LetsBuildRockets/ToF-CAN/hardware/id numbers.xls

CAN ID: 0x0620
CAN ID: 0x0621
CAN ID: 0x0622
CAN ID: 0x0623
CAN ID: 0x0624
CAN ID: 0x0625
CAN ID: 0x0626
CAN ID: 0x0627
CAN ID: 0x0628
CAN ID: 0x0629
CAN ID: 0x062A
CAN ID: 0x062B
CAN ID: 0x062C
CAN ID: 0x062D
CAN ID: 0x062E
CAN ID: 0x062F
CAN ID: 0x0630
CAN ID: 0x0631
CAN ID: 0x0632
CAN ID: 0x0633
CAN ID: 0x0634
CAN ID: 0x0635
CAN ID: 0x0636
CAN ID: 0x0637
CAN ID: 0x0638
CAN ID: 0x0639
CAN ID: 0x063A
CAN ID: 0x063B
CAN ID: 0x063C
CAN ID: 0x063D
CAN ID: 0x063E
CAN ID: 0x063F
CAN ID: 0x0640
CAN ID: 0x0641
CAN ID: 0x0642
CAN ID: 0x0643
CAN ID: 0x0644
CAN ID: 0x0645
CAN ID: 0x0646
CAN ID: 0x0647
CAN ID: 0x0648
CAN ID: 0x0649
CAN ID: 0x064A
CAN ID: 0x064B
CAN ID: 0x064C
CAN ID: 0x064D
CAN ID: 0x064E
CAN ID: 0x064F
CAN ID: 0x0650
CAN ID: 0x0651
CAN ID: 0x0652
CAN ID: 0x0653
CAN ID: 0x0654
CAN ID: 0x0655
CAN ID: 0x0656
CAN ID: 0x0657
CAN ID: 0x0658
CAN ID: 0x0659
CAN ID: 0x065A
CAN ID: 0x065B
CAN ID: 0x065C
CAN ID: 0x065D
CAN ID: 0x065E
CAN ID: 0x065F
CAN ID: 0x0660
CAN ID: 0x0661
CAN ID: 0x0662
CAN ID: 0x0663
CAN ID: 0x0664
CAN ID: 0x0665
CAN ID: 0x0666
CAN ID: 0x0667
CAN ID: 0x0668
CAN ID: 0x0669
CAN ID: 0x066A
CAN ID: 0x066B
CAN ID: 0x066C
CAN ID: 0x066D
CAN ID: 0x066E
CAN ID: 0x066F
CAN ID: 0x0670
CAN ID: 0x0671
CAN ID: 0x0672
CAN ID: 0x0673
CAN ID: 0x0674
CAN ID: 0x0675
CAN ID: 0x0676
CAN ID: 0x0677
CAN ID: 0x0678
CAN ID: 0x0679
CAN ID: 0x067A
CAN ID: 0x067B
CAN ID: 0x067C
CAN ID: 0x067D
CAN ID: 0x067E
CAN ID: 0x067F
CAN ID: 0x0680
CAN ID: 0x0681
CAN ID: 0x0682
CAN ID: 0x0683
CAN ID: 0x0684
CAN ID: 0x0685
CAN ID: 0x0686
CAN ID: 0x0687
CAN ID: 0x0688
CAN ID: 0x0689
CAN ID: 0x068A
CAN ID: 0x068B
CAN ID: 0x068C
CAN ID: 0x068D
CAN ID: 0x068E
CAN ID: 0x068F
CAN ID: 0x0690
CAN ID: 0x0691
CAN ID: 0x0692
CAN ID: 0x0693
CAN ID: 0x0694
CAN ID: 0x0695
CAN ID: 0x0696
CAN ID: 0x0697
CAN ID: 0x0698
CAN ID: 0x0699
CAN ID: 0x069A
CAN ID: 0x069B
CAN ID: 0x069C
CAN ID: 0x069D
CAN ID: 0x069E
CAN ID: 0x069F
CAN ID: 0x06A0
CAN ID: 0x06A1
CAN ID: 0x06A2
CAN ID: 0x06A3
CAN ID: 0x06A4
CAN ID: 0x06A5
CAN ID: 0x06A6
CAN ID: 0x06A7
CAN ID: 0x06A8
CAN ID: 0x06A9
CAN ID: 0x06AA
CAN ID: 0x06AB
CAN ID: 0x06AC
CAN ID: 0x06AD
CAN ID: 0x06AE
CAN ID: 0x06AF
CAN ID: 0x06B0
CAN ID: 0x06B1
CAN ID: 0x06B2
CAN ID: 0x06B3
CAN ID: 0x06B4
CAN ID: 0x06B5
CAN ID: 0x06B6
CAN ID: 0x06B7
CAN ID: 0x06B8
CAN ID: 0x06B9
CAN ID: 0x06BA
CAN ID: 0x06BB
CAN ID: 0x06BC
CAN ID: 0x06BD
CAN ID: 0x06BE
CAN ID: 0x06BF
CAN ID: 0x06C0
CAN ID: 0x06C1
CAN ID: 0x06C2
CAN ID: 0x06C3
CAN ID: 0x06C4
CAN ID: 0x06C5
CAN ID: 0x06C6
CAN ID: 0x06C7
CAN ID: 0x06C8
CAN ID: 0x06C9
CAN ID: 0x06CA
CAN ID: 0x06CB
CAN ID: 0x06CC
CAN ID: 0x06CD
CAN ID: 0x06CE
CAN ID: 0x06CF
CAN ID: 0x06D0
CAN ID: 0x06D1
CAN ID: 0x06D2
CAN ID: 0x06D3
CAN ID: 0x06D4
CAN ID: 0x06D5
CAN ID: 0x06D6
CAN ID: 0x06D7
CAN ID: 0x06D8
CAN ID: 0x06D9
CAN ID: 0x06DA
CAN ID: 0x06DB
CAN ID: 0x06DC
CAN ID: 0x06DD
CAN ID: 0x06DE
CAN ID: 0x06DF
CAN ID: 0x06E0
CAN ID: 0x06E1
CAN ID: 0x06E2
CAN ID: 0x06E3
CAN ID: 0x06E4
CAN ID: 0x06E5
CAN ID: 0x06E6
CAN ID: 0x06E7
CAN ID: 0x06E8
CAN ID: 0x06E9
CAN ID: 0x06EA
CAN ID: 0x06EB
CAN ID: 0x06EC
CAN ID: 0x06ED
CAN ID: 0x06EE
CAN ID: 0x06EF
CAN ID: 0x06F0
CAN ID: 0x06F1
CAN ID: 0x06F2
CAN ID: 0x06F3
CAN ID: 0x06F4
CAN ID: 0x06F5
CAN ID: 0x06F6
CAN ID: 0x06F7
CAN ID: 0x06F8
CAN ID: 0x06F9
CAN ID: 0x06FA
CAN ID: 0x06FB
CAN ID: 0x06FC
CAN ID: 0x06FD
CAN ID: 0x06FE
CAN ID: 0x06FF
