LetsBuildRockets/ToF-CAN/hardware/CAD/TOF Case P1.stl

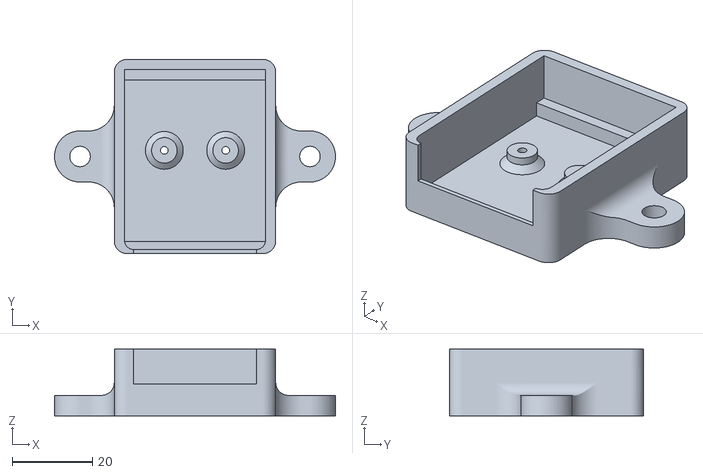
[picture p1: CAD file, 2019-03-20]
hardware/CAD/TOF Case P1.stl
69.8 x 48.3 x 16.6
