LetsBuildRockets/ToF-CAN/hardware/CAD/TOF Case P2_ISO.stl

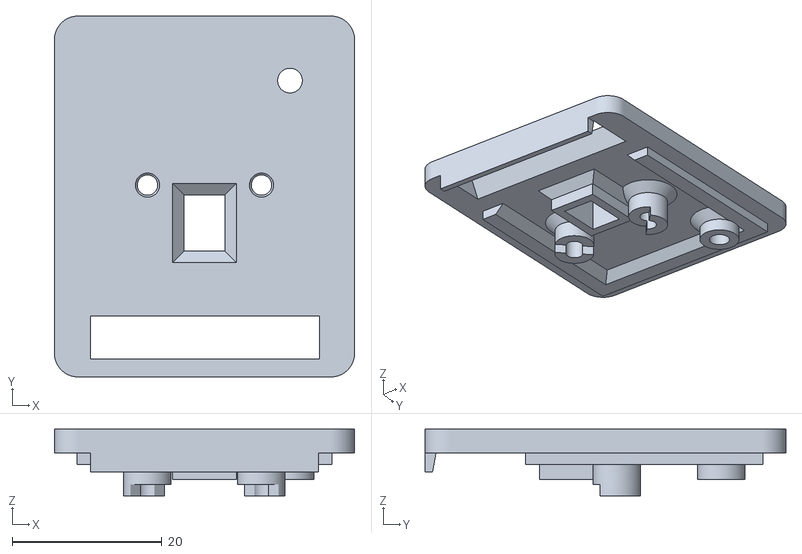
[picture p2: CAD file, 2019-03-20]
hardware/CAD/TOF Case P2_ISO.stl
40.1 x 48.3 x 8.92
