LetsBuildRockets/ToF-CAN/(list of files, cad)

Other CAD files:
hardware/CAD/TOF Assembly.dwg
hardware/CAD/CAN TOF/1X07.ipt
hardware/CAD/CAN TOF/B1,27.ipt
hardware/CAD/CAN TOF/Board.ipt
hardware/CAD/CAN TOF/C0402.ipt
hardware/CAD/CAN TOF/C0805.ipt
hardware/CAD/CAN TOF/CAN TOF.iam
hardware/CAD/CAN TOF/CTS406.ipt
hardware/CAD/CAN TOF/FUSC3216X100N.ipt
hardware/CAD/CAN TOF/ISP.ipt
hardware/CAD/CAN TOF/PCB Component.iam
hardware/CAD/CAN TOF/Pin.ipt
hardware/CAD/CAN TOF/R0805.ipt
hardware/CAD/CAN TOF/RGBLED5050.ipt
hardware/CAD/CAN TOF/SCREWTERMINAL-5MM-2.iam
hardware/CAD/CAN TOF/SMA-DO214AC.ipt
hardware/CAD/CAN TOF/SO08.ipt
hardware/CAD/CAN TOF/SO18W.ipt
hardware/CAD/CAN TOF/SOT-23.ipt
hardware/CAD/CAN TOF/SOT23-3.ipt
hardware/CAD/CAN TOF/ScrewTerminalCover.ipt
hardware/CAD/CAN TOF/TQFP32-08.ipt
hardware/CAD/CAN TOF/pan head cross recess screw_iso_ISO 7045 - M2 x 3 - Z - 3N.ipt
hardware/CAD/CAN TOF/part.ipt
hardware/CAD/TOF Assembly.iam
hardware/CAD/TOF Case P1.ipt
hardware/CAD/TOF Case P2.ipt
hardware/CAD/TOF Case P2_ISO.ipt
