LetsBuildRockets/ToF-CAN/hardware/CAN TOF.pdf

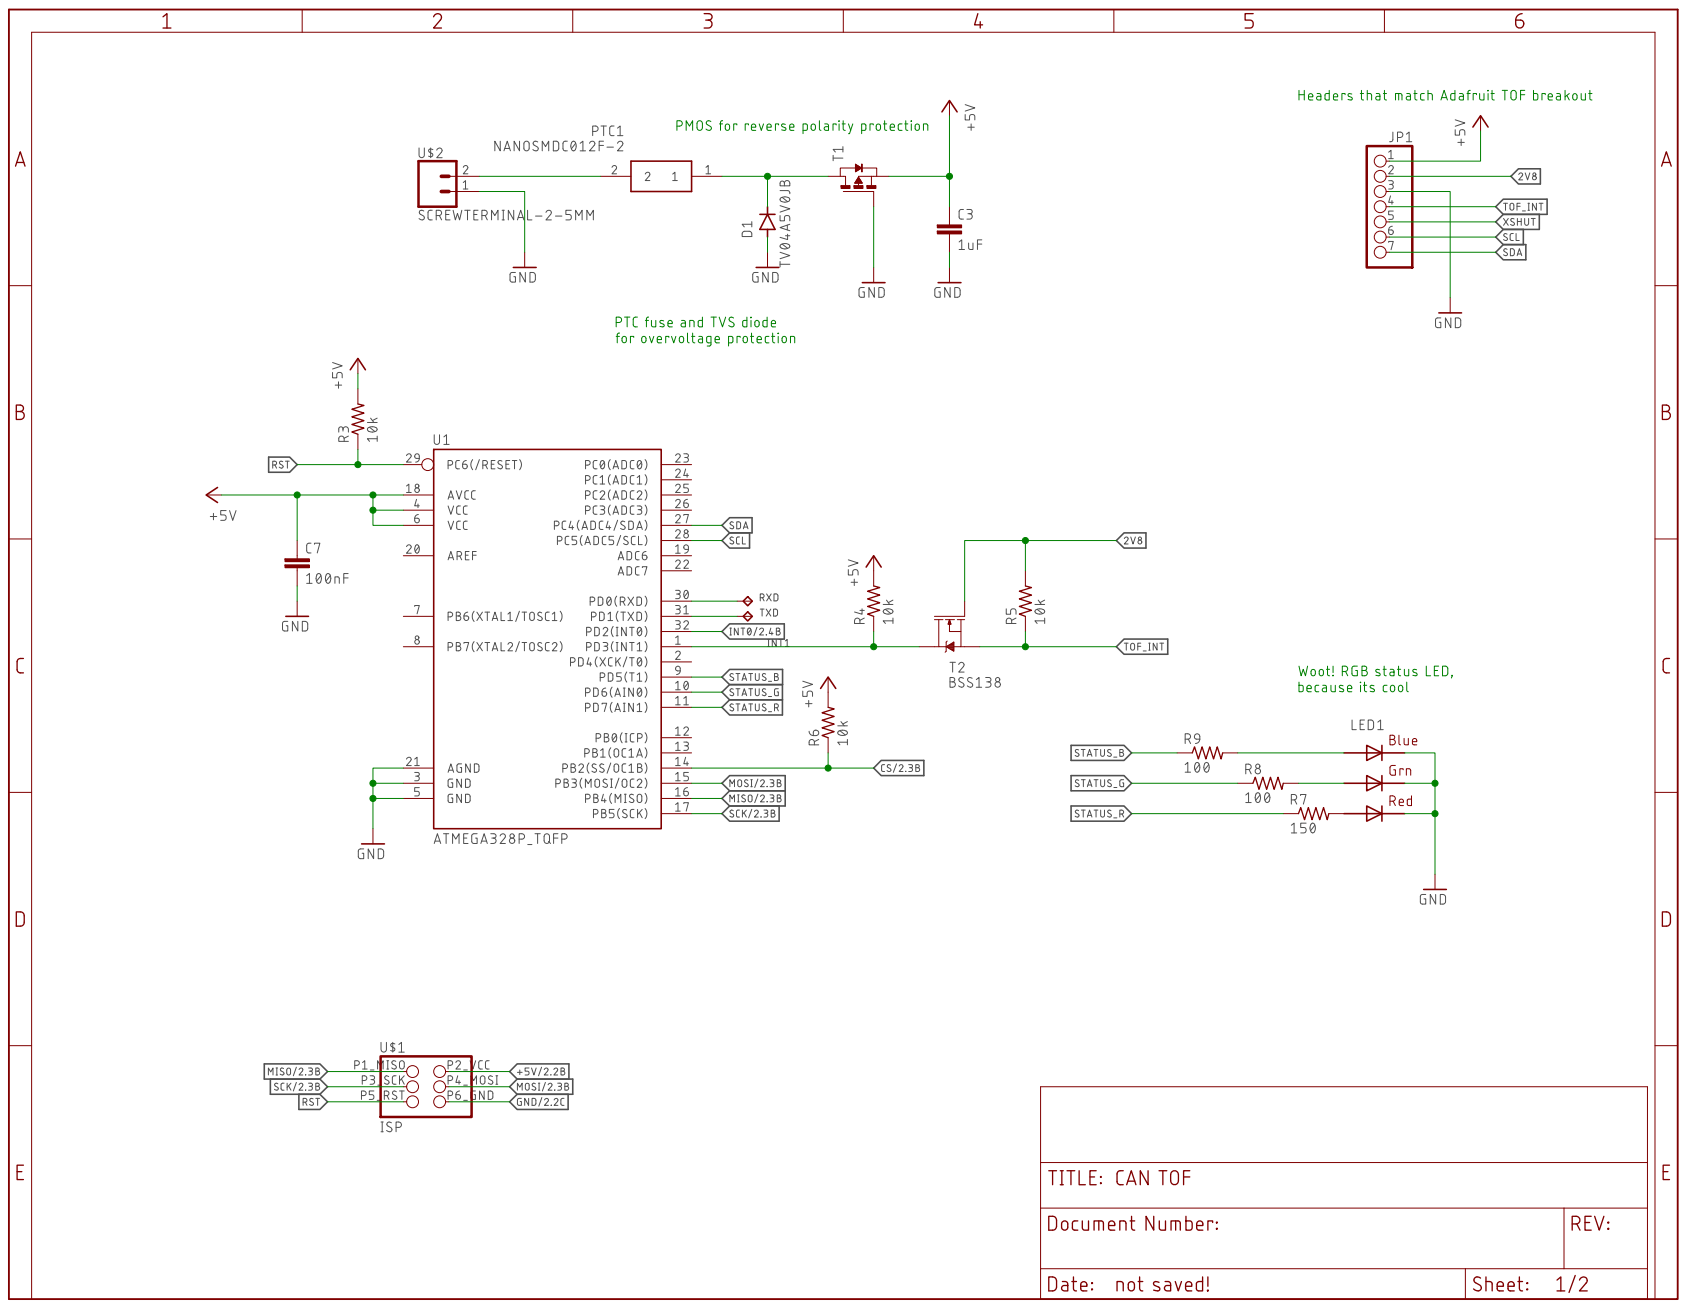
[picture p3: page 1]

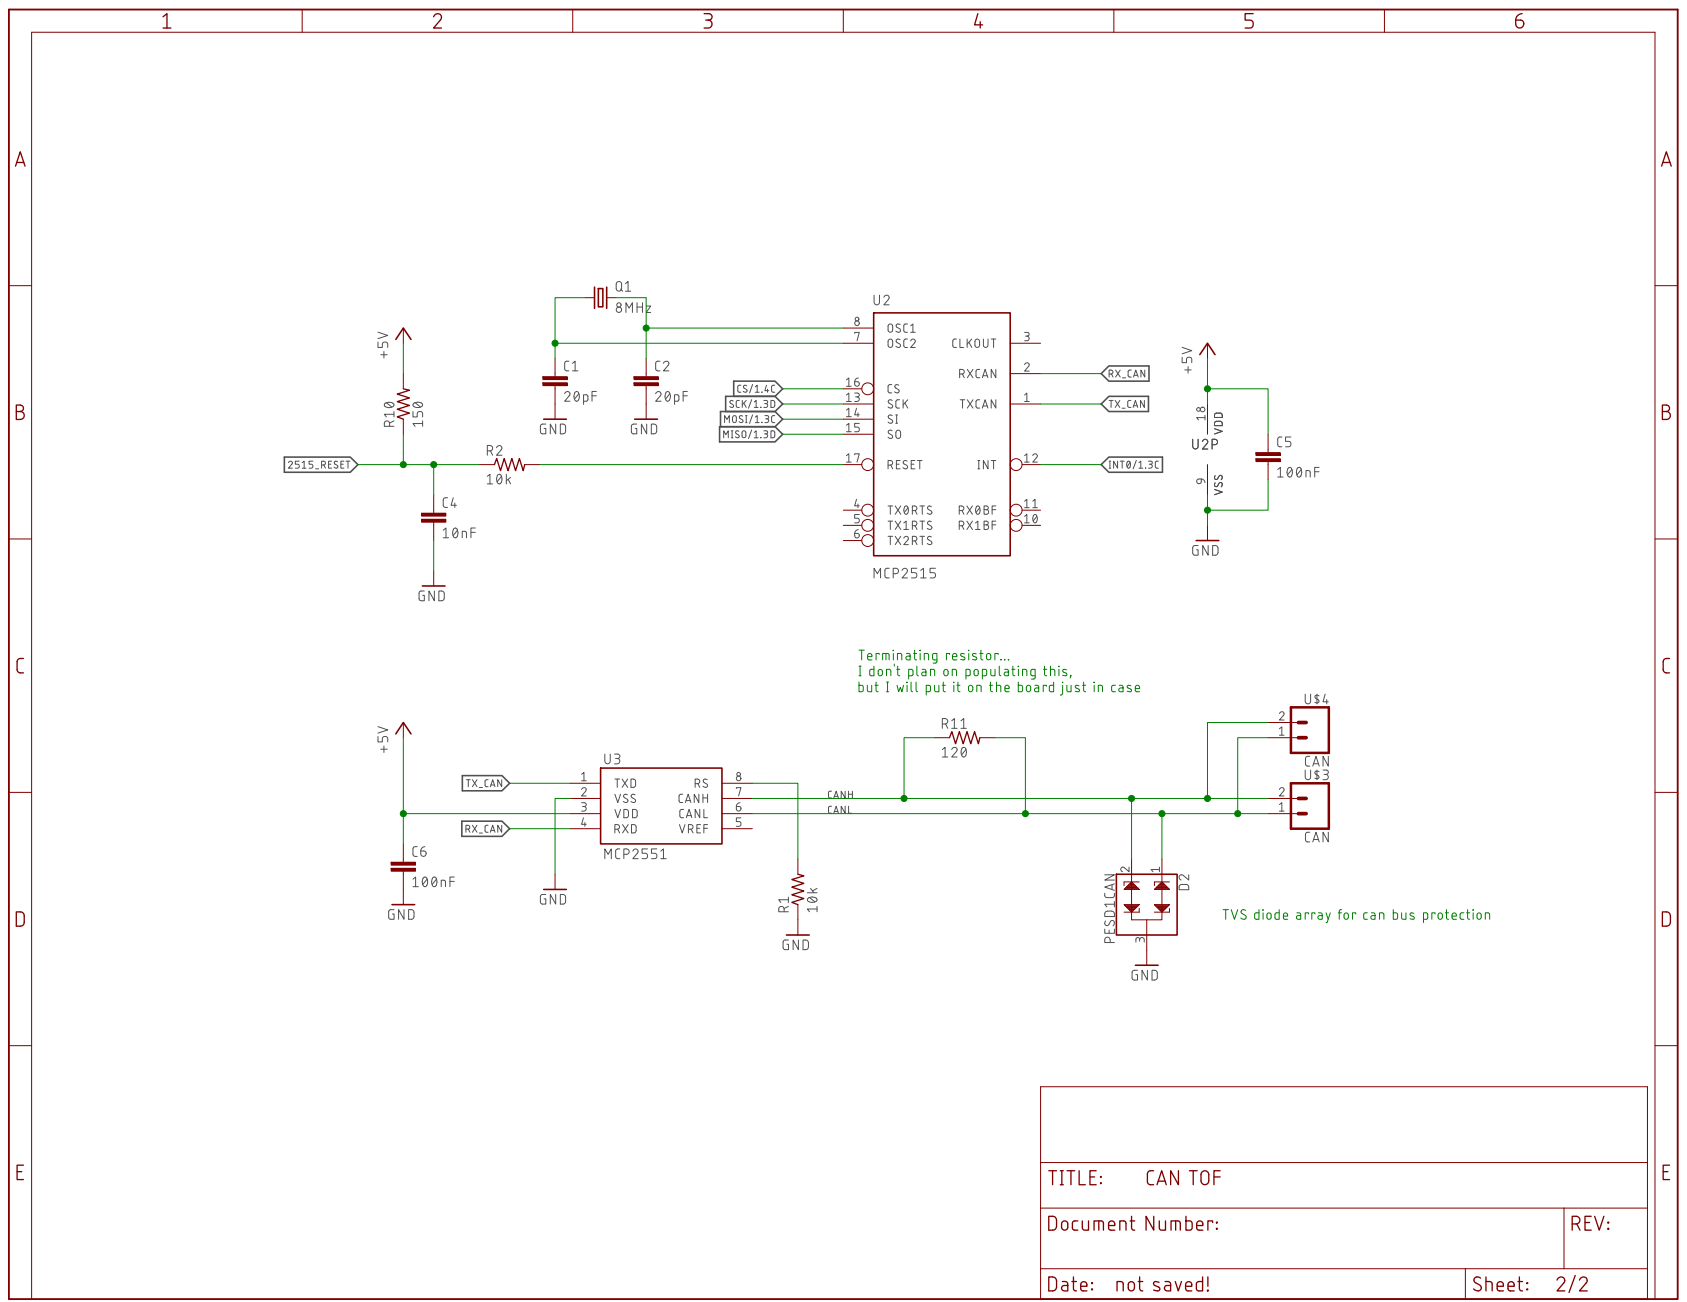
[picture p4: page 2]
