LetsBuildRockets/ToF-CAN/hardware/CAD/TOF Assembly.pdf

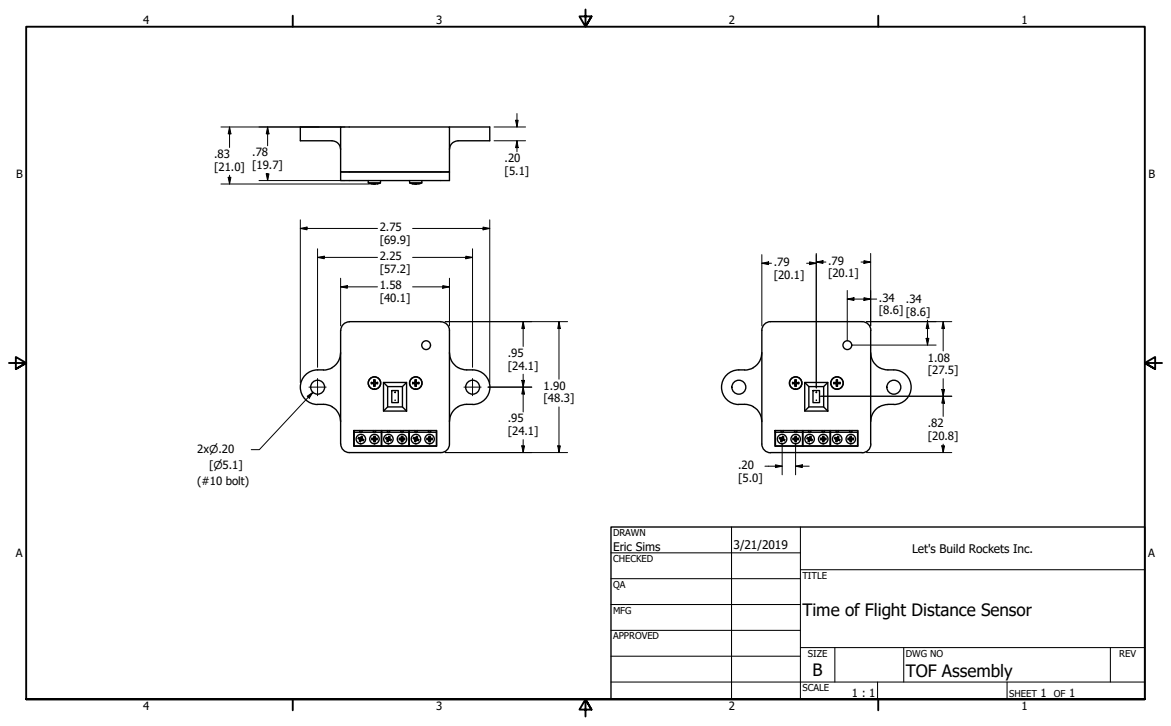
[picture p5: page 1]

D RA W N E r i c S i m s | 3 / 2 1 / 2 0 1 9 | L e t ' s B u ild R o c ke t s I n c .

S I Z E B | D W G N O T O F A s s e m bly | R E V
