LetsBuildRockets/ToF-CAN/hardware/CAN TOF.brd

## EAGLE design hardware/CAN TOF.brd (2019-03-20)

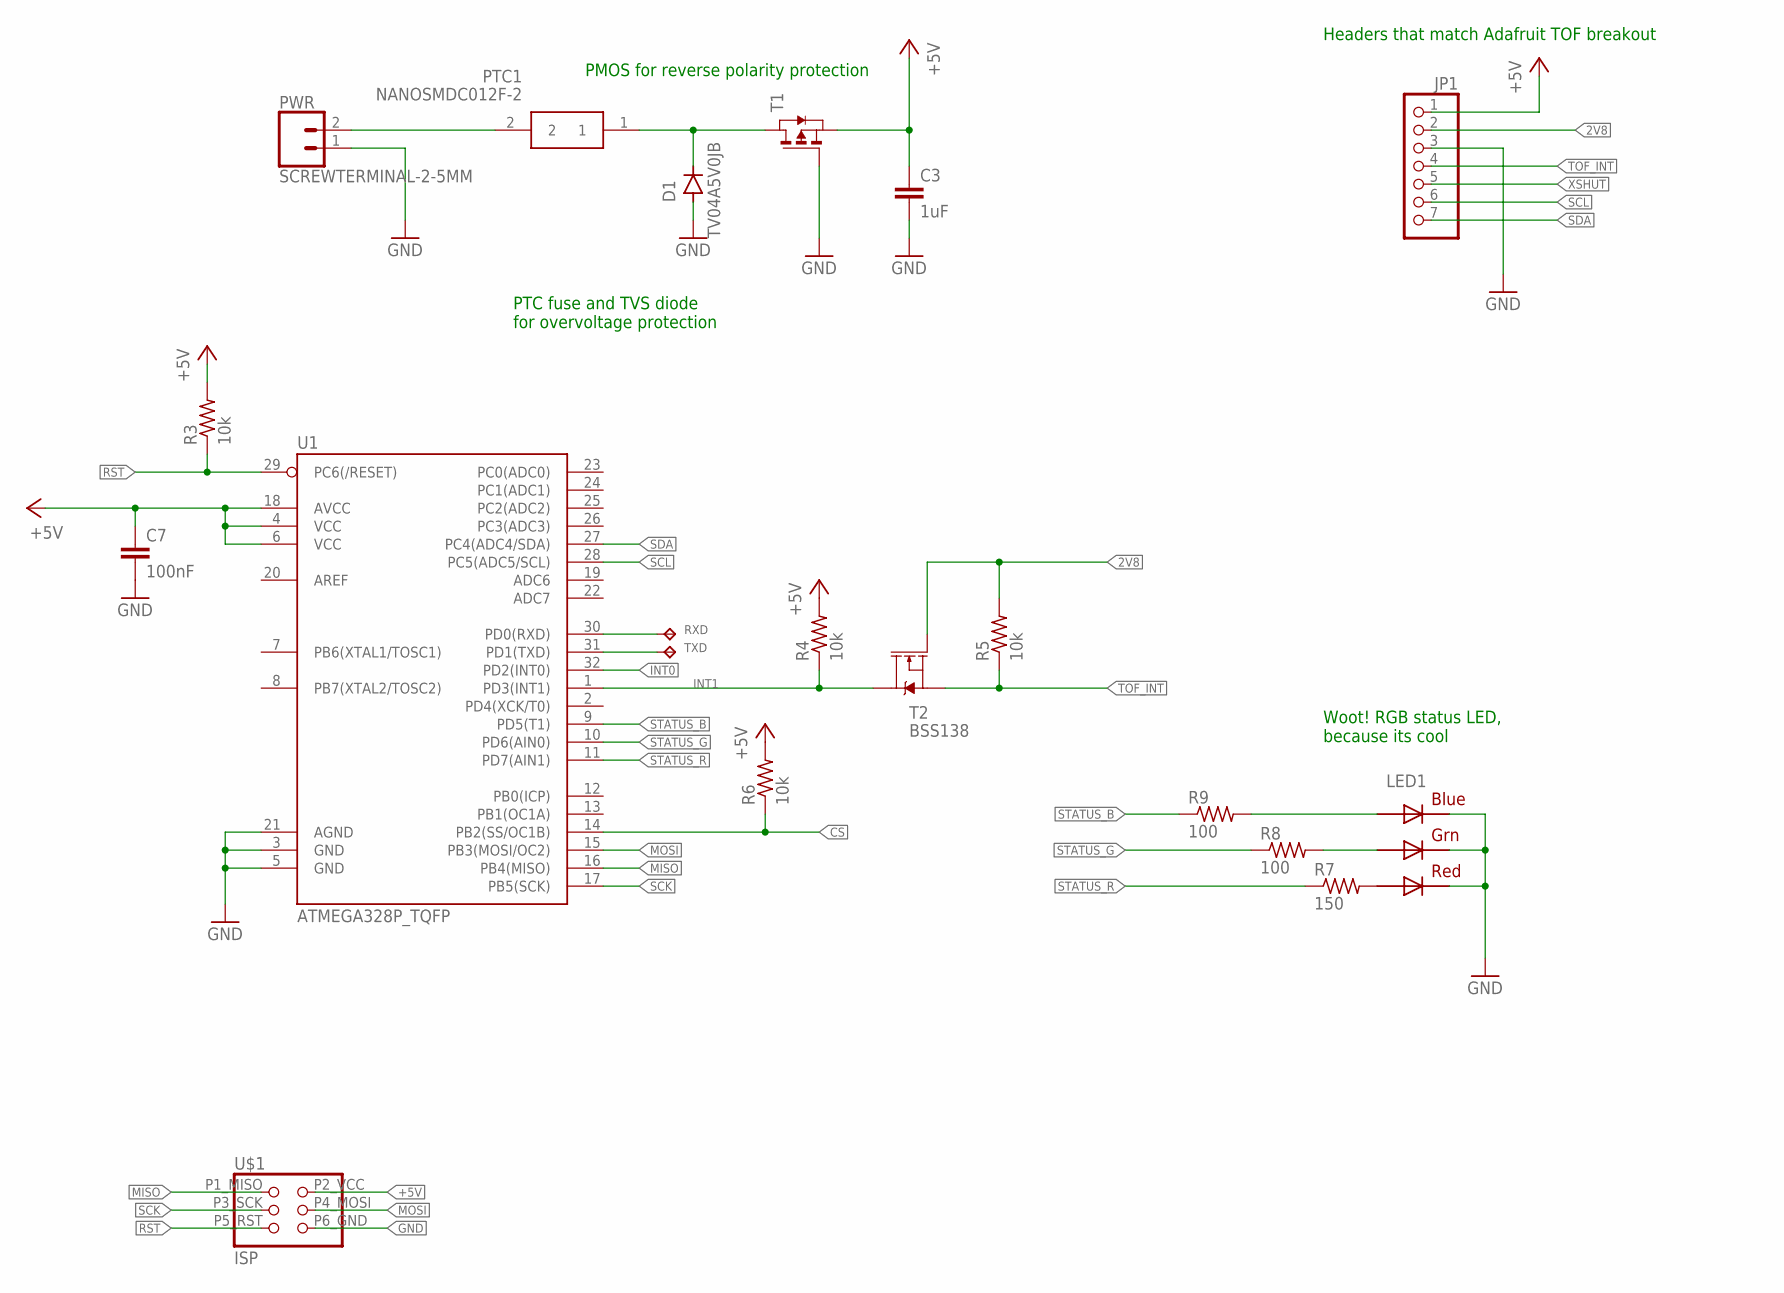
[picture p6: schematic CAN TOF.sch, sheet 1]

Parts:
C3: 1uF; C0805
C7: 100nF; C0402
D1: TV04A5V0JB; SMA-DO214AC
JP1: PINHD-1X7; 1X07
LED1: RGBLED5050
PTC1: NANOSMDC012F-2; FUSC3216X100N
PWR: SCREWTERMINAL-2-5MM; SCREWTERMINAL-5MM-2
R3, R4, R5, R6: 10k; R0805
R7: 150; R0805
R8, R9: 100; R0805
RXD: TPB1,27; B1,27
T1: PMOSSOT23; SOT-23
T2: BSS138; SOT23-3
TXD: TPB1,27; B1,27
U1: ATMEGA328P_TQFP; TQFP32-08
U$1: ISP

Connections:
2V8: JP1.2, R5.2, T2.1 (G)
+5V: C3.1, C7.1, JP1.1, R3.2, R4.2, R6.2, T1.2 (S), U1.4 (VCC), U1.6 (VCC), U1.18 (AVCC), U$1.P2_VCC (VCC); also elsewhere on the board
CS: R6.1, U1.14 (PB2(SS/OC1B)); also elsewhere on the board
GND: C3.2, C7.2, D1.A, JP1.3, LED1.4 (BLUE_C), LED1.5 (RED_C), LED1.6 (GREEN_C), PWR.1, T1.3 (G), U1.3 (GND), U1.5 (GND), U1.21 (AGND), U$1.P6_GND (GND); also elsewhere on the board
INT0: U1.32 (PD2(INT0)); also elsewhere on the board
INT1: R4.1, T2.3 (D), U1.1 (PD3(INT1))
MISO: U1.16 (PB4(MISO)), U$1.P1_MISO (MISO); also elsewhere on the board
MOSI: U1.15 (PB3(MOSI/OC2)), U$1.P4_MOSI (MOSI); also elsewhere on the board
unnamed: RXD.TP, U1.30 (PD0(RXD))
unnamed: TXD.TP, U1.31 (PD1(TXD))
unnamed: PTC1.2, PWR.2
unnamed: D1.K (C), PTC1.1, T1.1 (D)
unnamed: LED1.2 (RED_A), R7.2
unnamed: LED1.1 (GREEN_A), R8.2
unnamed: LED1.3 (BLUE_A), R9.2
RST: R3.1, U1.29 (PC6(/RESET)), U$1.P5_RST (RST)
SCK: U1.17 (PB5(SCK)), U$1.P3_SCK (SCK); also elsewhere on the board
SCL: JP1.6, U1.28 (PC5(ADC5/SCL))
SDA: JP1.7, U1.27 (PC4(ADC4/SDA))
STATUS_B: R9.1, U1.9 (PD5(T1))
STATUS_G: R8.1, U1.10 (PD6(AIN0))
STATUS_R: R7.1, U1.11 (PD7(AIN1))
TOF_INT: JP1.4, R5.1, T2.2 (S)
XSHUT: JP1.5

Notes on the sheet:
PTC fuse and TVS diode for overvoltage protection
PMOS for reverse polarity protection
Headers that match Adafruit TOF breakout
Woot! RGB status LED, because its cool

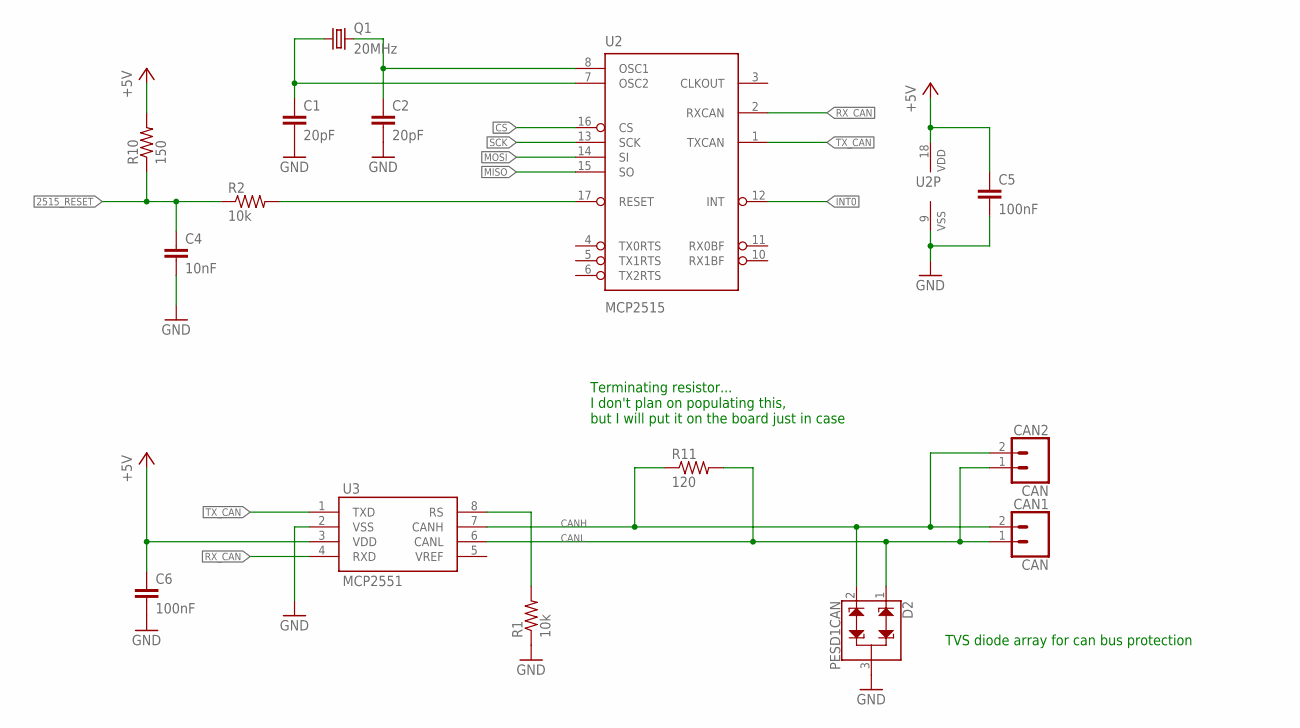
[picture p7: schematic CAN TOF.sch, sheet 2]

Parts:
C1, C2: 20pF; C0402
C4: 10nF; C0402
C5, C6: 100nF; C0402
CAN1, CAN2: CAN; SCREWTERMINAL-5MM-2
D2: PESD1CAN; SOT23-3
Q1: 20MHz; CTS406
R1, R2: 10k; R0805
R10: 150; R0805
R11: 120; R0805
U2: MCP2515; SO18W
U3: MCP2551; SO08

Connections:
2515_RESET: C4.1, R2.1, R10.1
+5V: C5.1, C6.1, R10.2, U2.18 (VDD), U3.3 (VDD); also elsewhere on the board
CANH: CAN1.2, CAN2.2, D2.2, R11.1, U3.7 (CANH)
CANL: CAN1.1, CAN2.1, D2.1, R11.2, U3.6 (CANL)
CS: U2.16 (CS); also elsewhere on the board
GND: C1.2, C2.2, C4.2, C5.2, C6.2, D2.3, R1.1, U2.9 (VSS), U3.2 (VSS); also elsewhere on the board
INT0: U2.12 (INT); also elsewhere on the board
MISO: U2.15 (SO); also elsewhere on the board
MOSI: U2.14 (SI); also elsewhere on the board
unnamed: R1.2, U3.8 (RS)
unnamed: R2.2, U2.17 (RESET)
unnamed: C1.1, Q1.1, U2.7 (OSC2)
unnamed: C2.1, Q1.3 (2), U2.8 (OSC1)
RX_CAN: U2.2 (RXCAN), U3.4 (RXD)
SCK: U2.13 (SCK); also elsewhere on the board
TX_CAN: U2.1 (TXCAN), U3.1 (TXD)

Notes on the sheet:
TVS diode array for can bus protection
Terminating resistor... I don't plan on populating this, but I will put it on the board just in case

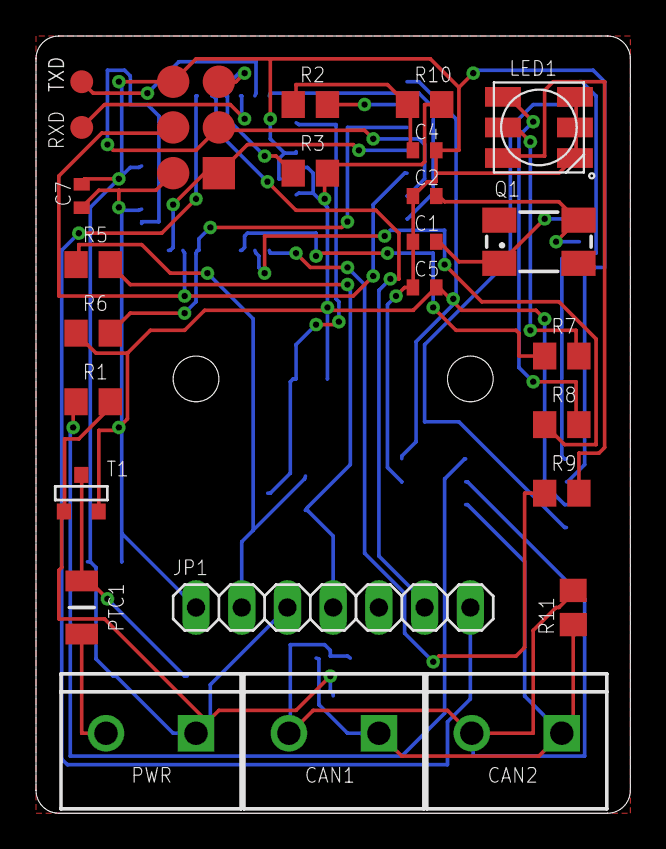
[picture p8: board CAN TOF.brd from above]

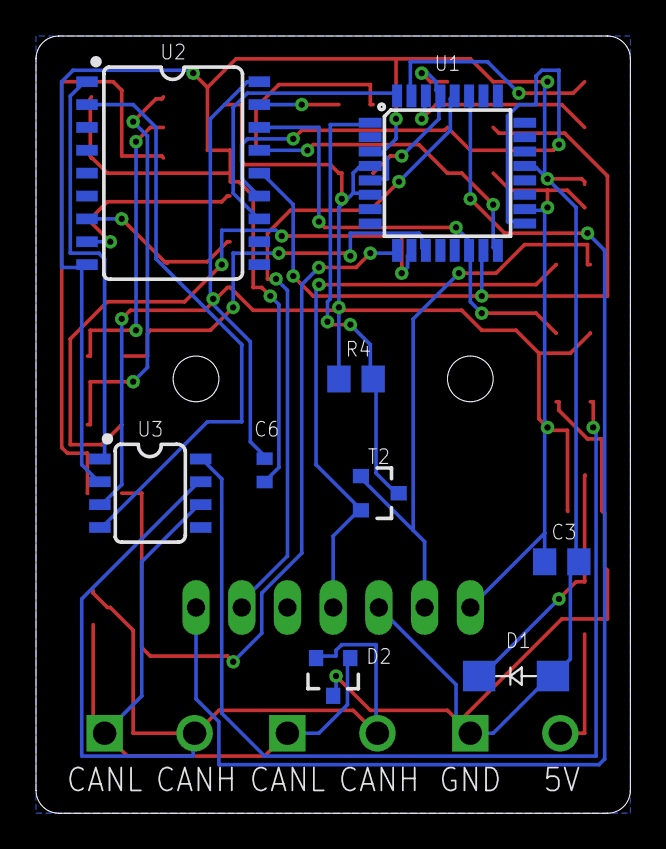
[picture p9: board CAN TOF.brd from below]

Board: 2 copper layers, 33.0 x 43.2 mm, 35 parts (9 on the bottom side), 32 nets.
