LetsBuildRockets/ToF-CAN/hardware/CAD/TOF Assembly Drawing.png

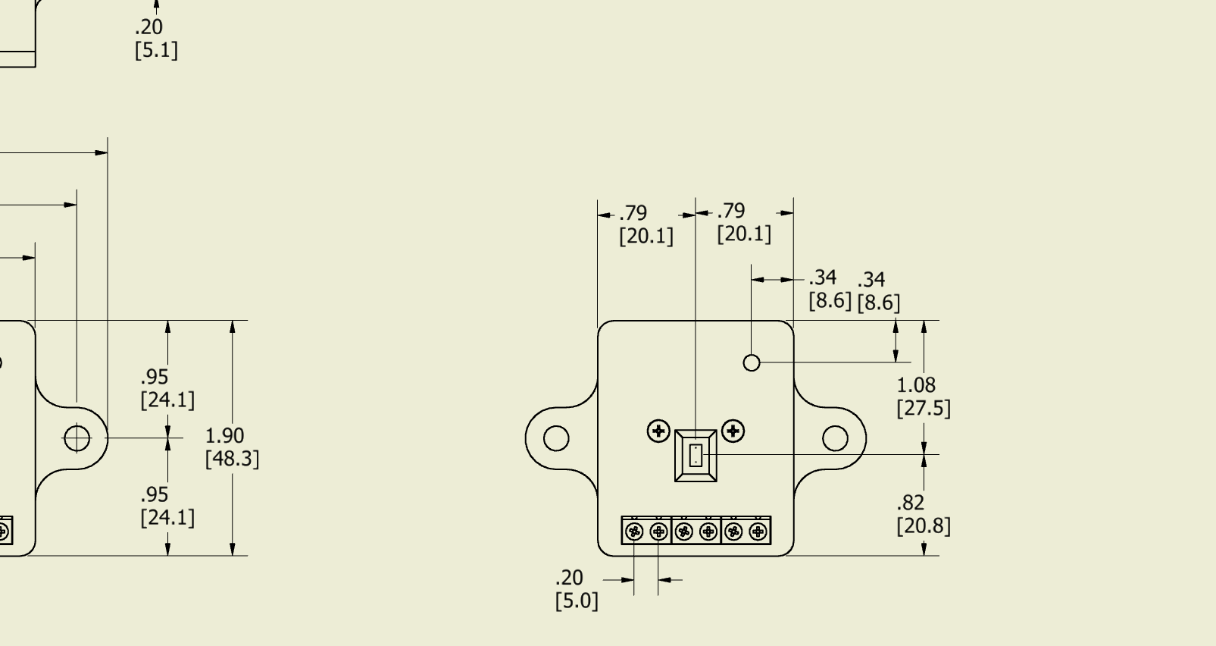
hardware/CAD/TOF Assembly Drawing.png
