LetsBuildRockets/ToF-CAN/(commit log)

2019-02-14 init with hardware files
    [1X07.ipt, B1,27.ipt, Board.ipt, C0402.ipt, C0805.ipt, CAN TOF.brd, CAN TOF.iam, CAN TOF.sch]
2019-03-01 switching to atmel studio. also there are proj files here. sue me.
    [CAN TOF.brd, CAN TOF.sch]
2019-03-01 ok hopefully we have i2c and VL53L0X support(?)
2019-03-01 ok so this reads out the distance from the ToF sensor and prints over UART
2019-03-01 oops wrong pin numbers
    [main.cpp]
2019-03-02 switching to 20Mhz crystal...
    [CAN TOF.brd, CAN TOF.sch]
2019-03-03 thickened up the case, and fixed component clearance issues
    [TOF Assembly.iam, TOF Case P1.ipt, TOF Case P1.stl, TOF Case P2.ipt, TOF Case P2_ISO.ipt, TOF Case P2_ISO.stl]
2019-03-20 wow, firmware is working, error codes, status light and all
    [main.cpp]
2019-03-20 add a little clearance to the screw terminals
    [TOF Case P2.ipt, TOF Case P2_ISO.stl]
2019-03-20 added a little more clearance to the case and added some labels
    [TOF Case P2.ipt, TOF Case P2_ISO.stl, id numbers.xls]
2019-03-22 updated the case a smidge, added some mech. drawings, and added frc release zip
    [TOF Assembly.dwg, TOF Assembly.iam, TOF Case P2_ISO.ipt]
2019-03-22 idk if this filter/mask thing works yet
2019-03-26 lets recv with interrupts
